MissouriMRDT/Science_Board_Hardware/Science_Board/Science_Board.kicad_pcb

## KiCad design Science_Board/Science_Board.kicad_pcb (2026-11-14)

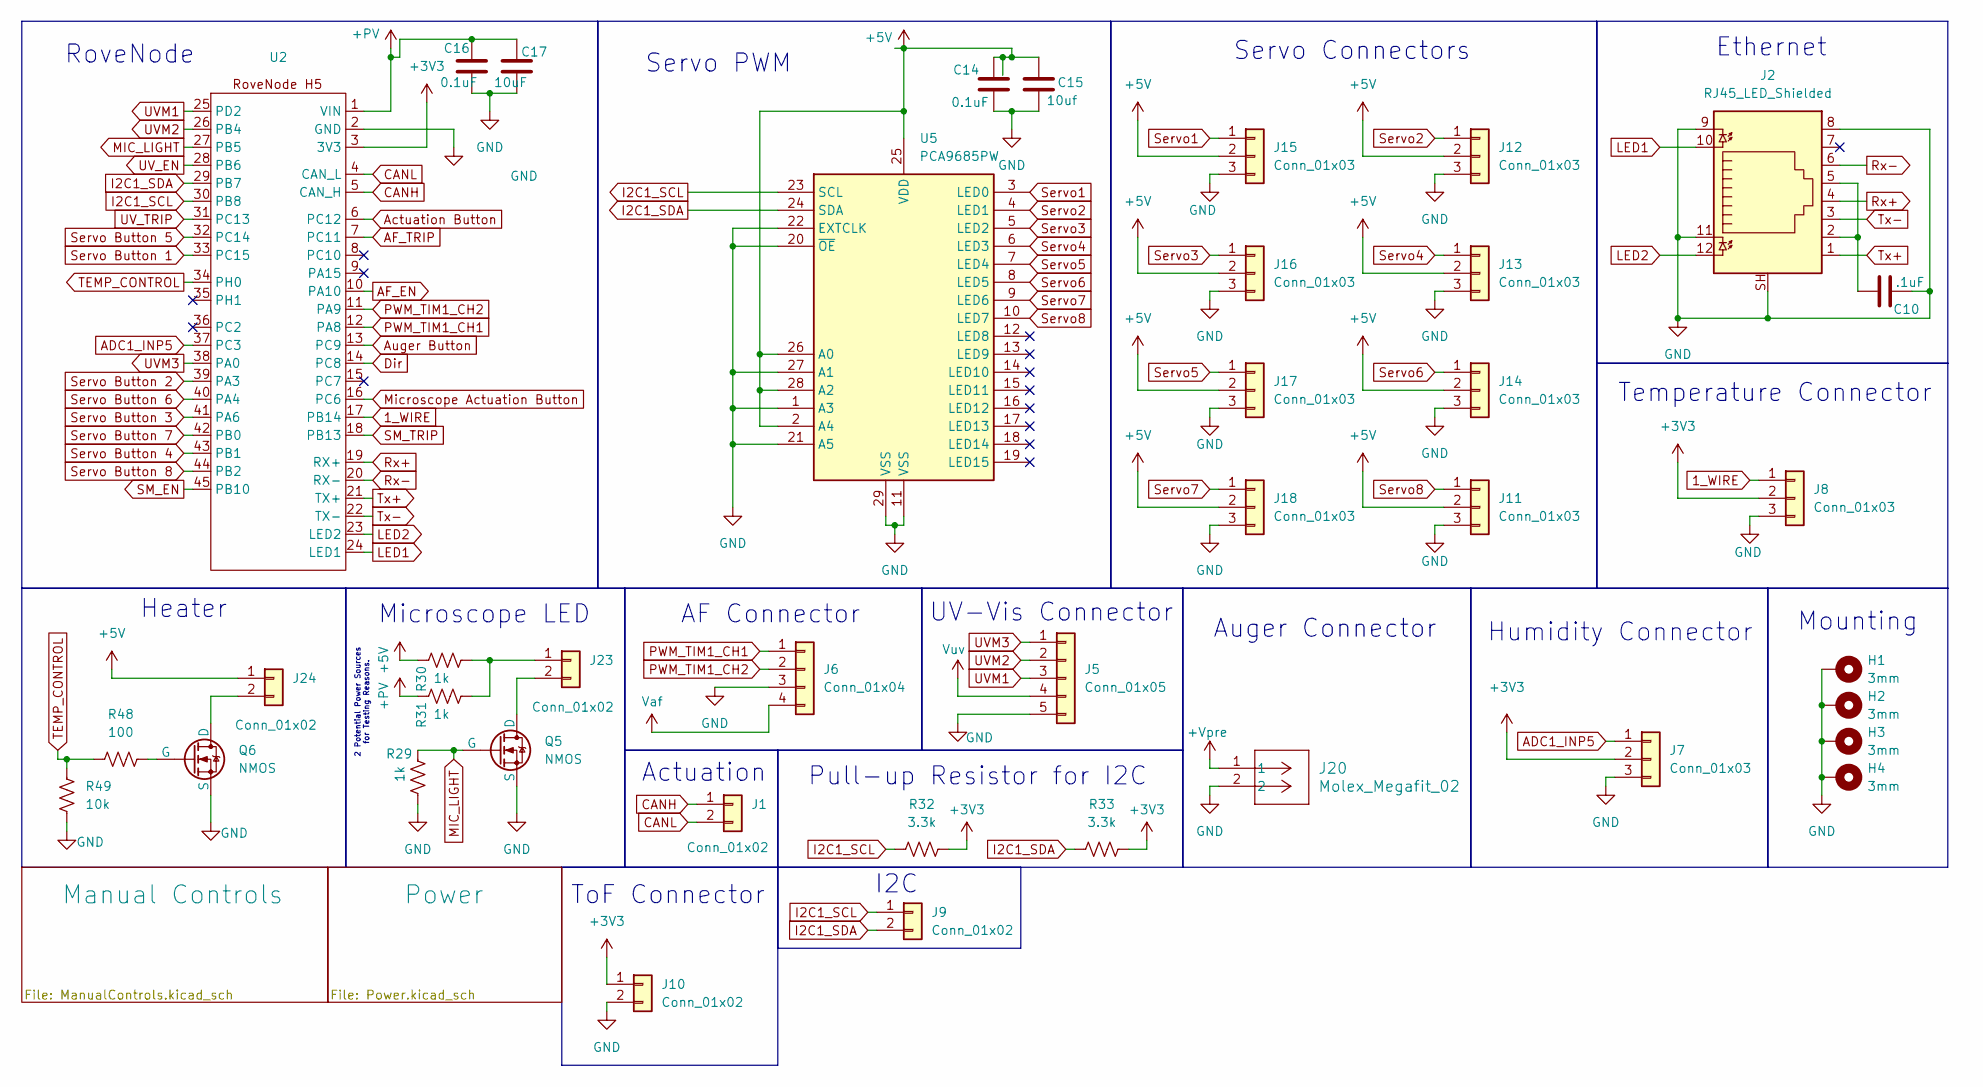
[picture p1: schematic Science_Board.kicad_sch]

Parts:
C10: .1uF; C_0603_1608Metric_Pad1.08x0.95mm_HandSolder
C14, C16: 0.1uF; C_0603_1608Metric_Pad1.08x0.95mm_HandSolder
C15: 10uf; C_0805_2012Metric_Pad1.18x1.45mm_HandSolder
C17: 10uF; C_0805_2012Metric_Pad1.18x1.45mm_HandSolder
H1, H2, H3, H4: 3mm; 4_40_Hole_Pad_Via
J1, J9, J10, J23, J24: Conn_01x02; JST_PH_B2B-PH-K_1x02_P2.00mm_Vertical
J2: RJ45_LED_Shielded; RJ45_Teensy
J5: Conn_01x05; JST_PH_B5B-PH-K_1x05_P2.00mm_Vertical
J6: Conn_01x04; JST_PH_B4B-PH-K_1x04_P2.00mm_Vertical
J7, J8, J11, J12, J13, J14, J15, J16, J17, J18: Conn_01x03; JST_PH_B3B-PH-K_1x03_P2.00mm_Vertical
J20: Molex_Megafit_02; MOLEX_MegaFit_02_Horizontal
Q5, Q6: NMOS; SOT-23-3
R29, R30, R31: 1k; R_0603_1608Metric_Pad0.98x0.95mm_HandSolder
R32, R33: 3.3k; R_0603_1608Metric_Pad0.98x0.95mm_HandSolder
R48: 100; R_0603_1608Metric_Pad0.98x0.95mm_HandSolder
R49: 10k; R_0603_1608Metric_Pad0.98x0.95mm_HandSolder
U2: RoveNode_H5
U5: PCA9685PW; HTSSOP-28-1EP_4.4x9.7mm_P0.65mm_EP2.75x6.2mm

Connections:
1_WIRE: J8.1, U2.17 (PB14)
+3V3: J7.2, J8.2, J10.1, R32.2, R33.2, U2.3 (3V3); also elsewhere on the board
+5V: C14.1, C15.2, J11.2, J12.2, J13.2, J14.2, J15.2, J16.2, J17.2, J18.2, J24.1, R30.1, U5.2 (A4), U5.25 (VDD), U5.26 (A0), U5.28 (A2); also elsewhere on the board
+PV: C16.1, C17.2, R31.1, U2.1 (VIN); also elsewhere on the board
+Vpre: J20.1; also elsewhere on the board
ADC1_INP5: J7.1, U2.37 (PC3)
AF_EN: U2.10 (PA10); also elsewhere on the board
AF_TRIP: U2.7 (PC11); also elsewhere on the board
Actuation Button: U2.6 (PC12); also elsewhere on the board
Auger Button: U2.13 (PC9); also elsewhere on the board
CANH: J1.1, U2.5 (CAN_H)
CANL: J1.2, U2.4 (CAN_L)
Dir: U2.14 (PC8); also elsewhere on the board
GND: C10.2, C14.2, C15.1, C16.2, C17.1, H1.1 (1_1), H2.1 (1_1), H3.1 (1_1), H4.1 (1_1), J2.8, J2.9, J2.11, J2.SH, J5.5, J6.3, J7.3, J8.3, J10.2, J11.3, J12.3, J13.3, J14.3, J15.3, J16.3, J17.3, J18.3, J20.2, Q5.3 (S), Q6.3 (S), R29.2, R49.1, U2.2 (GND), U5.1 (A3), U5.11 (VSS), U5.20 (~OE), U5.21 (A5), U5.22 (EXTCLK), U5.27 (A1), U5.29 (VSS); also elsewhere on the board
I2C1_SCL: J9.1, R32.1, U2.30 (PB8), U5.23 (SCL)
I2C1_SDA: J9.2, R33.1, U2.29 (PB7), U5.24 (SDA)
LED1: J2.10, U2.24 (LED1)
LED2: J2.12, U2.23 (LED2)
MIC_LIGHT: Q5.2 (G), R29.1, U2.27 (PB5)
Microscope Actuation Button: U2.16 (PC6); also elsewhere on the board
unnamed: C10.1, J2.2, J2.5
unnamed: J23.1, R30.2, R31.2
unnamed: J23.2, Q5.1 (D)
unnamed: J24.2, Q6.1 (D)
unnamed: Q6.2 (G), R48.2
PWM_TIM1_CH1: J6.1, U2.12 (PA8)
PWM_TIM1_CH2: J6.2, U2.11 (PA9)
Rx+: J2.4, U2.19 (RX+)
Rx-: J2.6, U2.20 (RX-)
SM_EN: U2.45 (PB10); also elsewhere on the board
SM_TRIP: U2.18 (PB13); also elsewhere on the board
Servo1: J15.1, U5.3 (LED0)
Servo2: J12.1, U5.4 (LED1)
Servo3: J16.1, U5.5 (LED2)
Servo4: J13.1, U5.6 (LED3)
Servo5: J17.1, U5.7 (LED4)
Servo6: J14.1, U5.8 (LED5)
Servo7: J18.1, U5.9 (LED6)
Servo8: J11.1, U5.10 (LED7)
Servo Button 1: U2.33 (PC15); also elsewhere on the board
Servo Button 2: U2.39 (PA3); also elsewhere on the board
Servo Button 3: U2.41 (PA6); also elsewhere on the board
Servo Button 4: U2.43 (PB1); also elsewhere on the board
Servo Button 5: U2.32 (PC14); also elsewhere on the board
Servo Button 6: U2.40 (PA4); also elsewhere on the board
Servo Button 7: U2.42 (PB0); also elsewhere on the board
Servo Button 8: U2.44 (PB2); also elsewhere on the board
TEMP_CONTROL: R48.1, R49.2, U2.34 (PH0)
Tx+: J2.1, U2.21 (TX+)
Tx-: J2.3, U2.22 (TX-)
UVM1: J5.3, U2.25 (PD2)
UVM2: J5.2, U2.26 (PB4)
UVM3: J5.1, U2.38 (PA0)
UV_EN: U2.28 (PB6); also elsewhere on the board
UV_TRIP: U2.31 (PC13); also elsewhere on the board
Vaf: J6.4; also elsewhere on the board
Vuv: J5.4; also elsewhere on the board

Notes on the sheet:
UV-Vis Connector
Servo Connectors
Auger Connector
Temperature Connector
Servo PWM
ToF Connector
AF Connector
Microscope LED
RoveNode
Heater
Pull-up Resistor for I2C
Ethernet
Mounting
2 Potential Power Sources for Testing Reasons.
Actuation
I2C
Humidity Connector

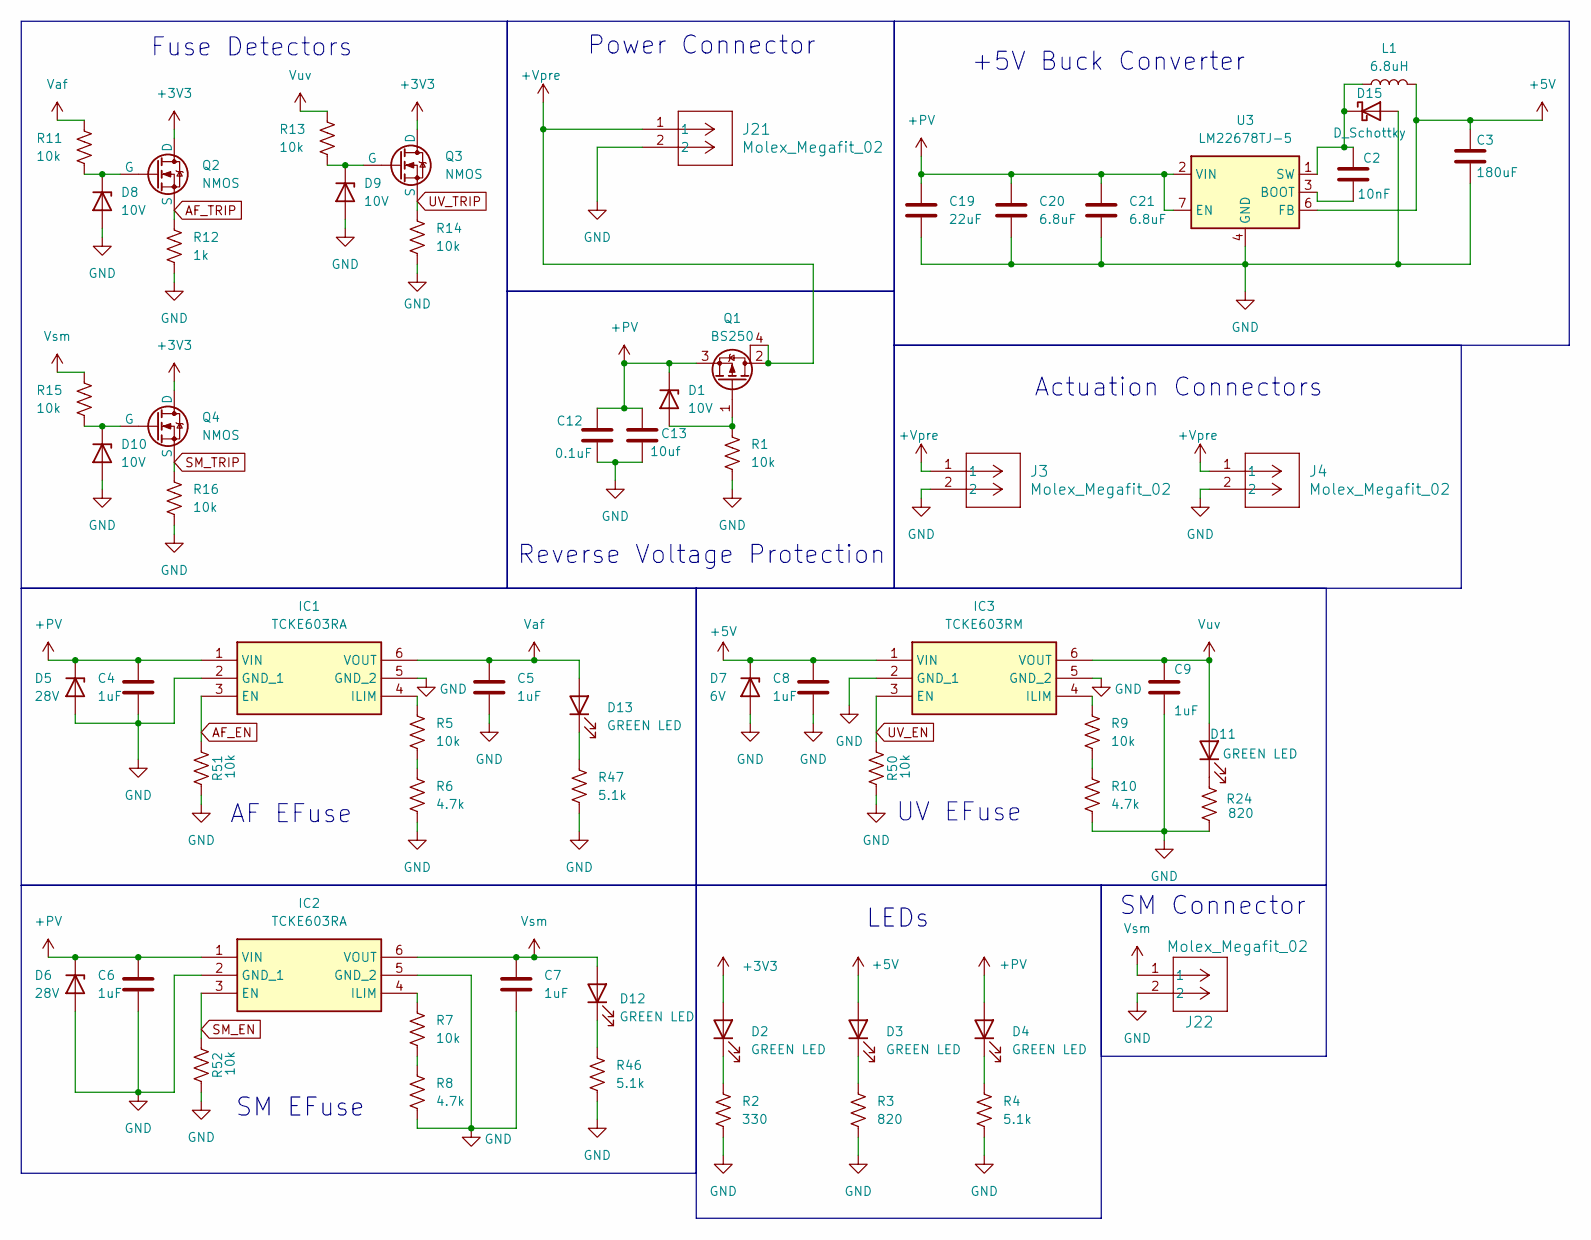
[picture p2: schematic Power.kicad_sch]

Parts:
C2: 10nF; C_0603_1608Metric_Pad1.08x0.95mm_HandSolder
C3: 180uF; CAP_EEEFNE181XUL
C4, C5, C6, C7, C8, C9: 1uF; C_0603_1608Metric_Pad1.08x0.95mm_HandSolder
C12: 0.1uF; C_0603_1608Metric_Pad1.08x0.95mm_HandSolder
C13: 10uf; C_0805_2012Metric_Pad1.18x1.45mm_HandSolder
C19: 22uF; C_1206_3216Metric_Pad1.33x1.80mm_HandSolder
C20, C21: 6.8uF; C_1206_3216Metric_Pad1.33x1.80mm_HandSolder
D1, D8, D9, D10: 10V; D_SOD-323_HandSoldering
D2, D3, D4, D11, D12, D13: GREEN LED; LED_0603_1608Metric_Pad1.05x0.95mm_HandSolder
D5, D6: 28V; D_SOD-123
D7: 6V; D_SOD-323_HandSoldering
D15: D_Schottky; D_SOD-128
IC1, IC2: TCKE603RA; TCKE602RM; Manufacturer_Part_Number TCKE602RM
IC3: TCKE603RM; TCKE602RM; Manufacturer_Part_Number TCKE602RM
J3, J4, J21, J22: Molex_Megafit_02; MOLEX_MegaFit_02_Horizontal
L1: 6.8uH; L_Bourns_SRN8040TA
Q1: BS250; SOT-223
Q2, Q3, Q4: NMOS; SOT-23-3
R1, R5, R7, R9, R11, R13, R14, R15, R16: 10k; R_0603_1608Metric_Pad0.98x0.95mm_HandSolder
R2: 330; R_0603_1608Metric_Pad0.98x0.95mm_HandSolder
R3, R24: 820; R_0603_1608Metric_Pad0.98x0.95mm_HandSolder
R4, R46, R47: 5.1k; R_0603_1608Metric_Pad0.98x0.95mm_HandSolder
R6, R8, R10: 4.7k; R_0603_1608Metric_Pad0.98x0.95mm_HandSolder
R12: 1k; R_0603_1608Metric_Pad0.98x0.95mm_HandSolder
R50, R51, R52: 10k
U3: LM22678TJ-5; TO-263-7_TabPin8

Connections:
+3V3: D2.2 (A), Q2.1 (D), Q3.1 (D), Q4.1 (D); also elsewhere on the board
+5V: C3.1, C8.1, D3.2 (A), D7.1 (K), IC3.1 (VIN), L1.2, U3.6 (FB); also elsewhere on the board
+PV: C4.1, C6.1, C12.1, C13.2, C19.1, C20.1, C21.1, D1.1 (K), D4.2 (A), D5.1 (K), D6.1 (K), IC1.1 (VIN), IC2.1 (VIN), Q1.3 (S), U3.2 (VIN), U3.7 (EN); also elsewhere on the board
+Vpre: J3.1, J4.1, J21.1, Q1.2 (D), Q1.4 (D); also elsewhere on the board
AF_EN: IC1.3 (EN), R51.1; also elsewhere on the board
AF_TRIP: Q2.3 (S), R12.1; also elsewhere on the board
GND: C3.2, C4.2, C5.2, C6.2, C7.2, C8.2, C9.2, C12.2, C13.1, C19.2, C20.2, C21.2, D5.2 (A), D6.2 (A), D7.2 (A), D8.2 (A), D9.2 (A), D10.2 (A), D15.2 (A), IC1.2 (GND_1), IC1.5 (GND_2), IC2.2 (GND_1), IC2.5 (GND_2), IC3.2 (GND_1), IC3.5 (GND_2), J3.2, J4.2, J21.2, J22.2, R1.1, R2.2, R3.2, R4.2, R6.2, R8.2, R10.2, R12.2, R14.2, R16.2, R24.2, R46.2, R47.2, R50.2, R51.2, R52.2, U3.4 (GND), U3.8 (GND); also elsewhere on the board
unnamed: D1.2 (A), Q1.1 (G), R1.2
unnamed: D2.1 (K), R2.1
unnamed: D3.1 (K), R3.1
unnamed: D4.1 (K), R4.1
unnamed: D8.1 (K), Q2.2 (G), R11.2
unnamed: D9.1 (K), Q3.2 (G), R13.2
unnamed: D10.1 (K), Q4.2 (G), R15.2
unnamed: D11.1 (K), R24.1
unnamed: D12.1 (K), R46.1
unnamed: D13.1 (K), R47.1
unnamed: C2.1, D15.1 (K), L1.1, U3.1 (SW)
unnamed: IC1.4 (ILIM), R5.1
unnamed: IC2.4 (ILIM), R7.1
unnamed: IC3.4 (ILIM), R9.1
unnamed: R5.2, R6.1
unnamed: R7.2, R8.1
unnamed: R9.2, R10.1
unnamed: C2.2, U3.3 (BOOT)
SM_EN: IC2.3 (EN), R52.1; also elsewhere on the board
SM_TRIP: Q4.3 (S), R16.1; also elsewhere on the board
UV_EN: IC3.3 (EN), R50.1; also elsewhere on the board
UV_TRIP: Q3.3 (S), R14.1; also elsewhere on the board
Vaf: C5.1, D13.2 (A), IC1.6 (VOUT), R11.1; also elsewhere on the board
Vsm: C7.1, D12.2 (A), IC2.6 (VOUT), J22.1, R15.1
Vuv: C9.1, D11.2 (A), IC3.6 (VOUT), R13.1; also elsewhere on the board

Notes on the sheet:
Reverse Voltage Protection
Fuse Detectors
Power Connector
+5V Buck Converter
AF EFuse
SM EFuse
UV EFuse
Actuation Connectors
LEDs
SM Connector

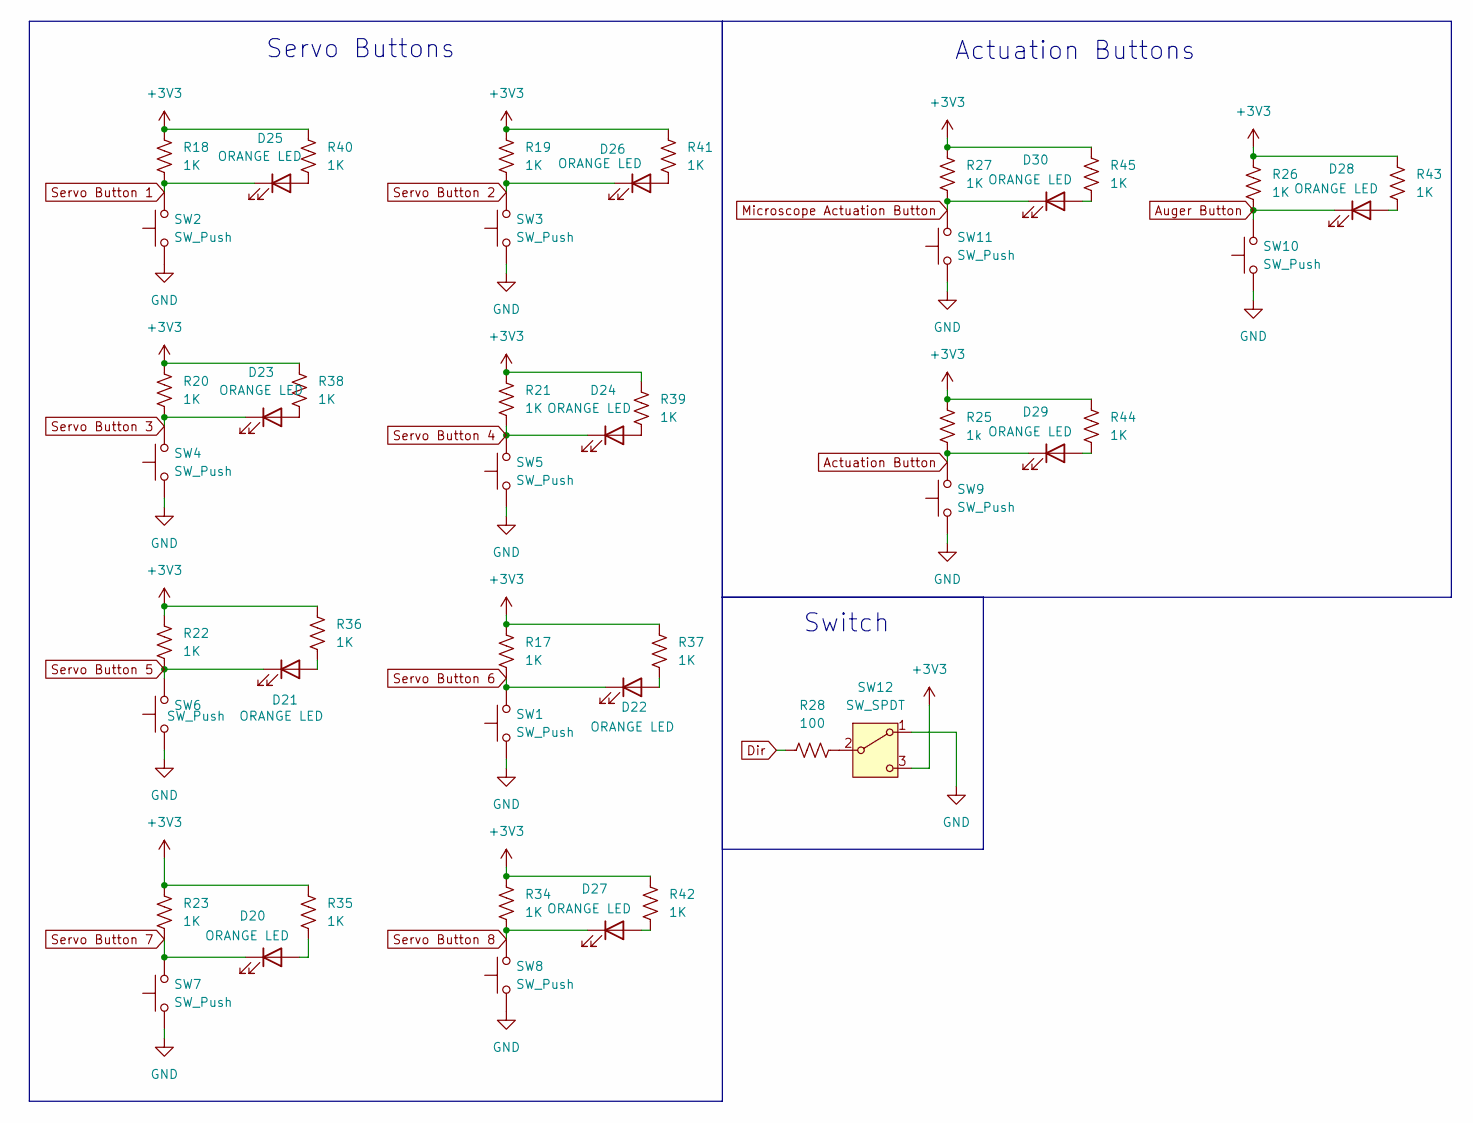
[picture p3: schematic ManualControls.kicad_sch]

Parts:
D20, D21, D22, D23, D24, D25, D26, D27, D28, D29, D30: ORANGE LED; LED_0603_1608Metric_Pad1.05x0.95mm_HandSolder
R17, R18, R19, R20, R21, R22, R23, R26, R27, R34, R35, R36, R37, R38, R39, R40, R41, R42, R43, R44, R45: 1K; R_0603_1608Metric_Pad0.98x0.95mm_HandSolder
R25: 1k; R_0603_1608Metric_Pad0.98x0.95mm_HandSolder
R28: 100; R_0603_1608Metric_Pad0.98x0.95mm_HandSolder
SW1, SW2, SW3, SW4, SW5, SW6, SW7, SW8, SW9, SW10, SW11: SW_Push; SW_SPST_TL3305A
SW12: SW_SPDT; SW_Slide_SPDT_Straight_CK_OS102011MS2Q

Connections:
+3V3: R17.1, R18.1, R19.1, R20.1, R21.1, R22.1, R23.1, R25.1, R26.1, R27.1, R34.1, R35.1, R36.1, R37.1, R38.1, R39.1, R40.1, R41.1, R42.1, R43.1, R44.1, R45.1, SW12.3 (C); also elsewhere on the board
Actuation Button: D29.1 (K), R25.2, SW9.2; also elsewhere on the board
Auger Button: D28.1 (K), R26.2, SW10.2; also elsewhere on the board
Dir: R28.1; also elsewhere on the board
GND: SW1.1, SW2.1, SW3.1, SW4.1, SW5.1, SW6.1, SW7.1, SW8.1, SW9.1, SW10.1, SW11.1, SW12.1 (A); also elsewhere on the board
Microscope Actuation Button: D30.1 (K), R27.2, SW11.2; also elsewhere on the board
unnamed: D20.2 (A), R35.2
unnamed: D21.2 (A), R36.2
unnamed: D22.2 (A), R37.2
unnamed: D23.2 (A), R38.2
unnamed: D24.2 (A), R39.2
unnamed: D25.2 (A), R40.2
unnamed: D26.2 (A), R41.2
unnamed: D27.2 (A), R42.2
unnamed: D28.2 (A), R43.2
unnamed: D29.2 (A), R44.2
unnamed: D30.2 (A), R45.2
unnamed: R28.2, SW12.2 (B)
Servo Button 1: D25.1 (K), R18.2, SW2.2; also elsewhere on the board
Servo Button 2: D26.1 (K), R19.2, SW3.2; also elsewhere on the board
Servo Button 3: D23.1 (K), R20.2, SW4.2; also elsewhere on the board
Servo Button 4: D24.1 (K), R21.2, SW5.2; also elsewhere on the board
Servo Button 5: D21.1 (K), R22.2, SW6.2; also elsewhere on the board
Servo Button 6: D22.1 (K), R17.2, SW1.2; also elsewhere on the board
Servo Button 7: D20.1 (K), R23.2, SW7.2; also elsewhere on the board
Servo Button 8: D27.1 (K), R34.2, SW8.2; also elsewhere on the board

Notes on the sheet:
Actuation Buttons
Switch
Servo Buttons

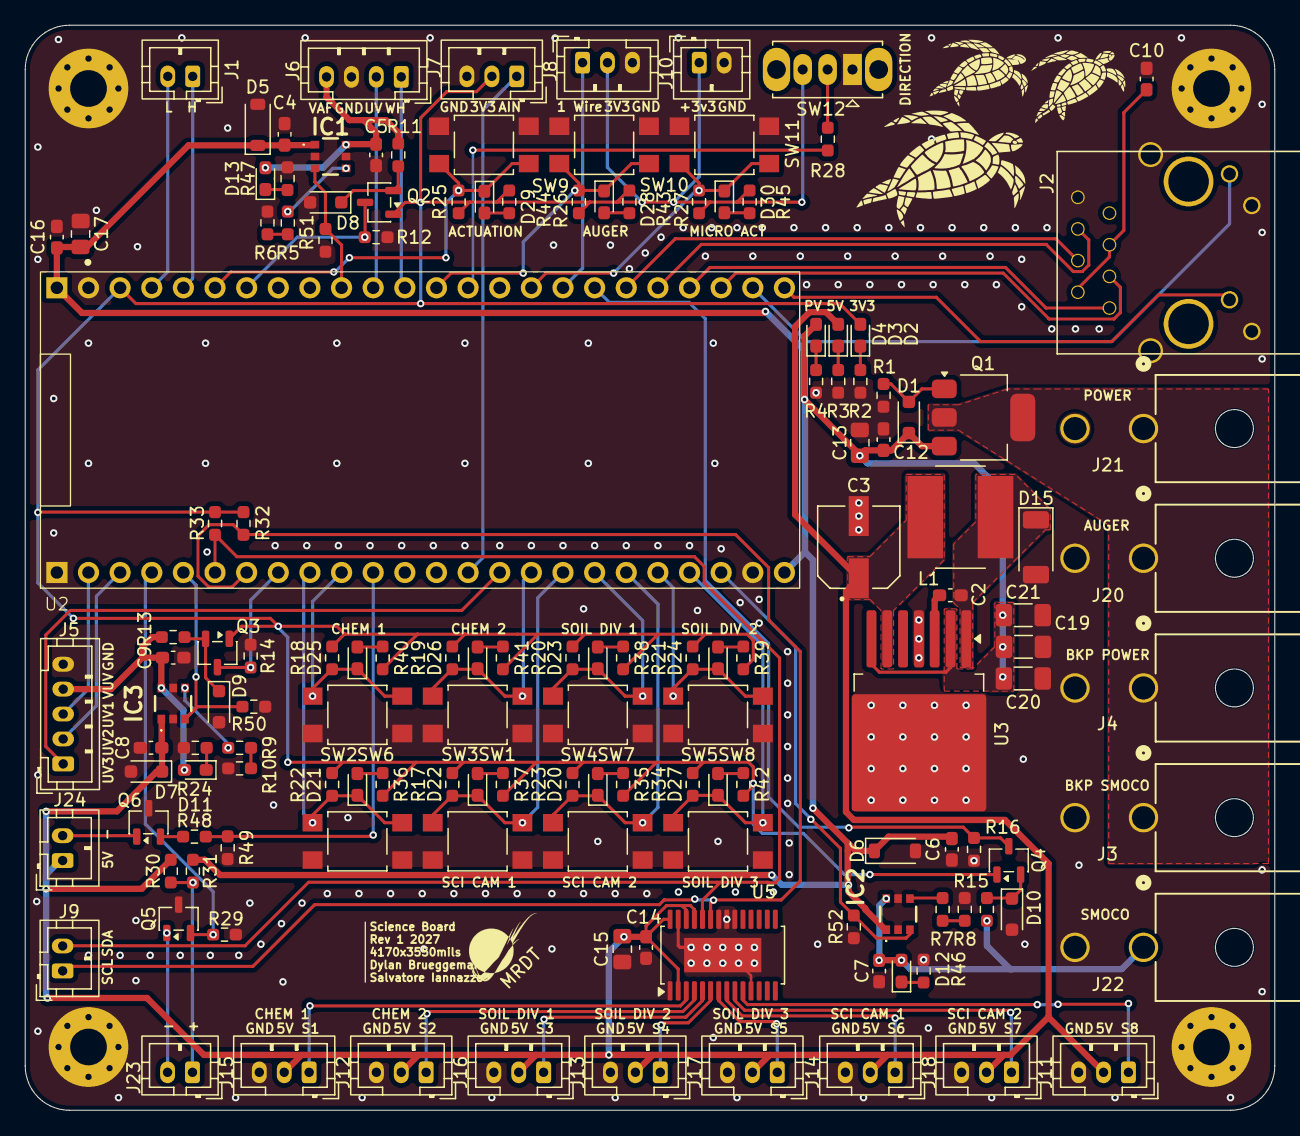
[picture p4: board Science_Board.kicad_pcb from above]

Board: 4 copper layers, 100.3 x 87.1 mm, 147 parts (0 on the bottom side), 88 nets.
