MissouriMRDT/Science_Board_Hardware/(commit log)

2026-09-16 Project Initialization
    [Science_Board.kicad_pcb, Science_Board.kicad_sch]
2026-10-02 +5V Buck Converter
    [Dylan.kicad_sch, Science_Board.kicad_sch]
2026-10-02 Starting Reverse Voltage Protection
    [untitled.kicad_sch]
2026-10-02 Reverse Voltage Protection Complete
    [untitled.kicad_sch]
2026-10-02 Added the power LEDs
    [Salvatore_sch.kicad_sch, Science_Board.kicad_sch]
2026-10-05 added the PWM driver
    [Salvatore_sch.kicad_sch]
2026-10-06 changed text boxes
    [Salvatore_sch.kicad_sch]
2026-10-06 changed to right board and put correct inputs into some parts
    [Salvatore_sch.kicad_sch]
2026-10-06 EFuses
    They done
    [Salvatore_sch.kicad_sch, untitled.kicad_sch]
2026-10-07 Added Connectors
    [Science_Board.kicad_sch, anthony.kicad_sch]
2026-10-07 Condensed all sheets into main or the power sheet
    [Power.kicad_sch, Science_Board.kicad_sch]
2026-10-12 reconnected the PWM servo board
2026-10-13 fuse trip
2026-10-13 Added RJ45 Connector
2026-10-13 Add Footprints
2026-10-13 Added mounting holes
2026-10-14 Fixed Reverse Voltage Protection, small formatting fixes
2026-10-15 Created the 11 buttons and the switch
2026-10-16 fixed some mistakes like making a box for buttons and the voltage flag being wrong for PWM driver
2026-10-16 created decoupling capacitors
2026-10-20 fixed some of the issues in the doc like actuatoin to actuation and getting the servo buttons and servos on the same numbering scheme
2026-10-20 Changed footprint of resistors inductors and capacitors
2026-10-20 changed more footprints
2026-10-20 finished footprints
2026-10-20 some footprints didn't save so I fixed that
2026-10-21 created button sheet added LEDs for the buttons and the E-fuses
2026-10-23 changed capacitor and started on layout
2026-10-23 Got all the buttons close to eachother
2026-10-23 fixed pwm driver and a connecter footprint
2026-10-23 moved stuff off board
2026-10-23 fixed the 1wire pin
2026-10-25 Seperated all of the circuits for layout
2026-10-27 changed the buck to the correct footprint
2026-10-27 fix mosfet
2026-10-28 added temp connector =
2026-10-28 fixed footprint
2026-10-29 got the correct diode
2026-10-29 Diode now has the correct footprint and made the mounting holes the correct distance apart
2026-10-31 Added pulldown resistors to the fuse enable pins
2026-11-05 started to wire the board
2026-11-06 did more layout wiring mostly connecting close components together
2026-11-06 corrected the +Pv trace most of the way
2026-11-06 routed more traces
2026-11-07 Made Schematic Look Nice
    yahoo
2026-11-07 new schematic changes
2026-11-07 finished the traces and fixed all the ground planes not being connected
2026-11-13 no more gnd errors
2026-11-14 cool board
2026-11-14 better signal and silkscreen
